slightly-engineered/micro-crawler-2x-6mm-planetary-gear-motors/stl/micro crawler body.stl

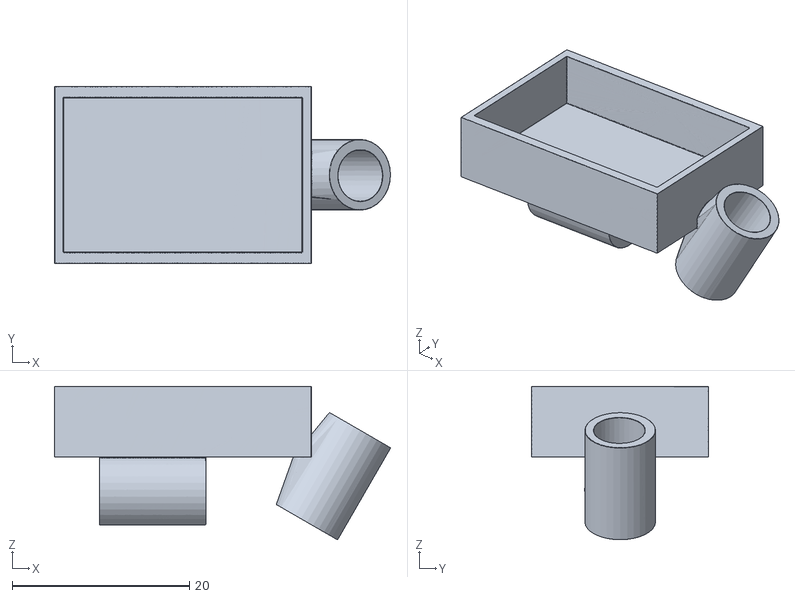
[picture p5: CAD file, 2026-10-30]
stl/micro crawler body.stl
37.9 x 20.0 x 17.3
