slightly-engineered/micro-crawler-2x-6mm-planetary-gear-motors/stl/front motor.stl

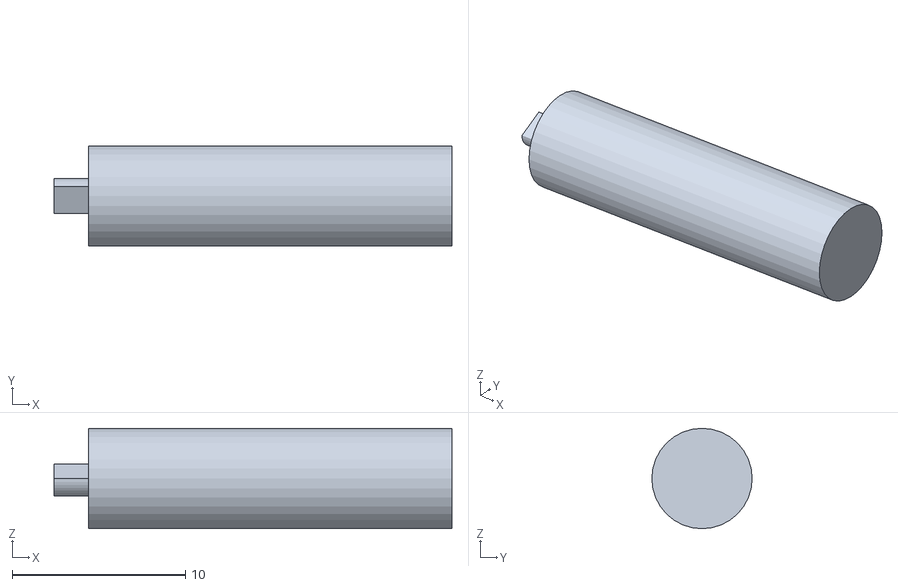
[picture p6: CAD file, 2026-10-30]
stl/front motor.stl
23.0 x 5.80 x 5.80
