slightly-engineered/micro-crawler-2x-6mm-planetary-gear-motors/stl/6mm planetary motor horn.stl

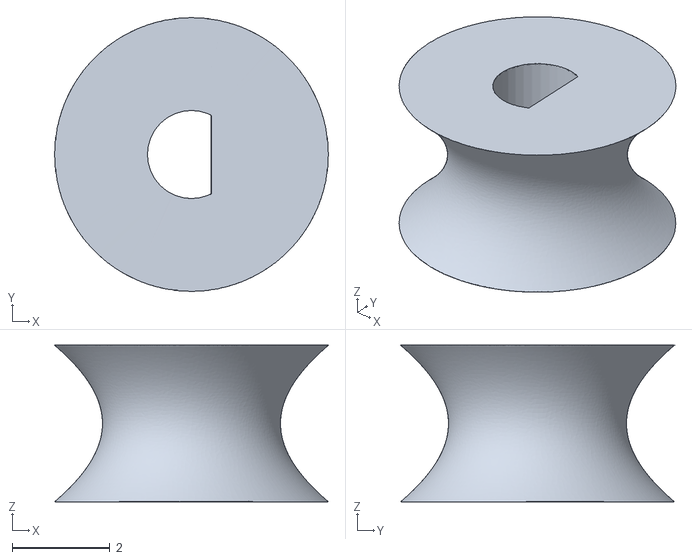
[picture p7: CAD file, 2026-10-30]
stl/6mm planetary motor horn.stl
5.60 x 5.60 x 3.20
