slightly-engineered/micro-crawler-2x-6mm-planetary-gear-motors/stl/rear motor.stl

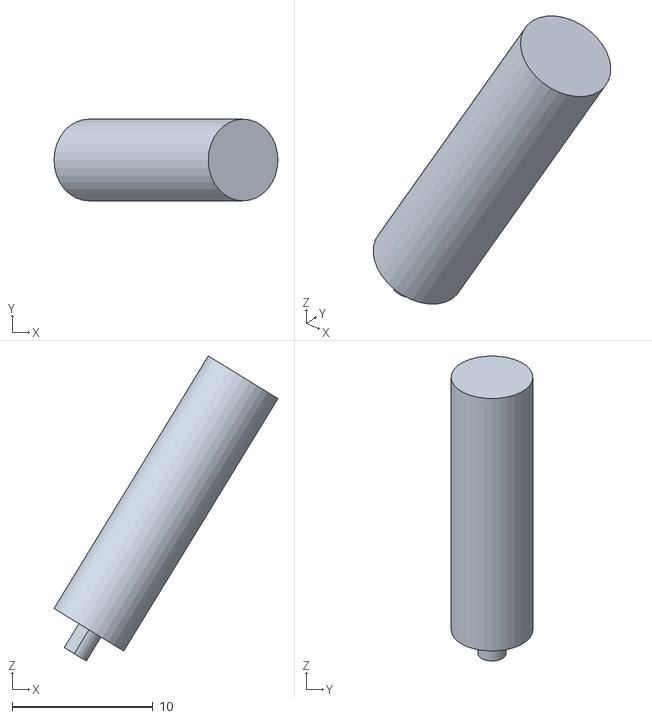
[picture p8: CAD file, 2026-10-30]
stl/rear motor.stl
15.9 x 5.80 x 21.7
