slightly-engineered/micro-crawler-2x-6mm-planetary-gear-motors/stl/DRV8833.stl

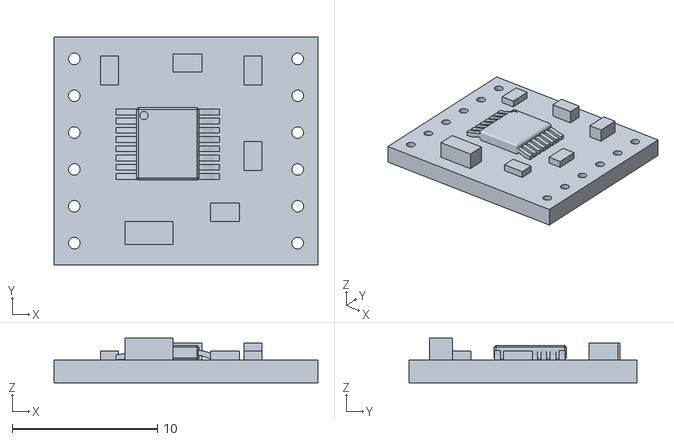
[picture p9: CAD file, 2026-10-30]
stl/DRV8833.stl
18.2 x 15.7 x 3.10
