slightly-engineered/micro-crawler-2x-6mm-planetary-gear-motors/stl/battery dummy.stl

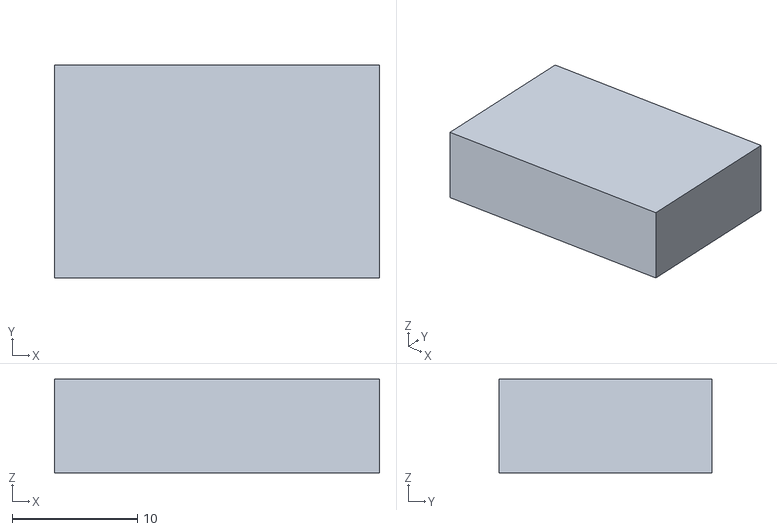
[picture p10: CAD file, 2026-10-30]
stl/battery dummy.stl
26.0 x 17.0 x 7.50
