slightly-engineered/micro-crawler-2x-6mm-planetary-gear-motors/stl/Arduino ESP32-C3.stl

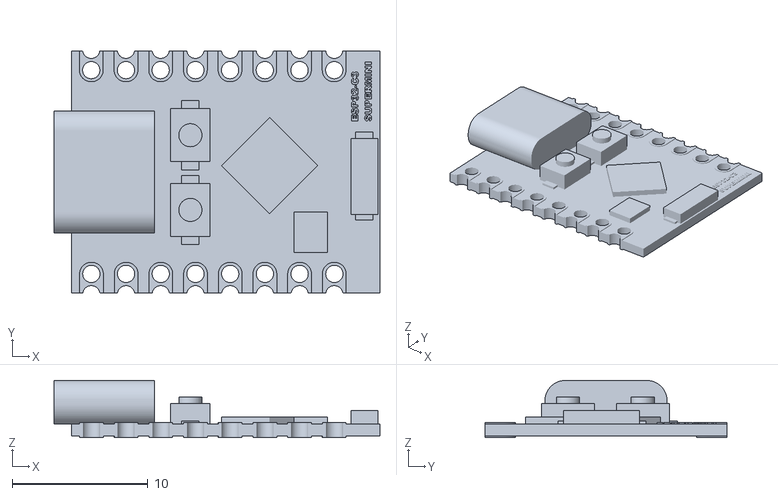
[picture p11: CAD file, 2026-10-30]
stl/Arduino ESP32-C3.stl
24.0 x 17.8 x 4.20
