slightly-engineered/micro-crawler-2x-6mm-planetary-gear-motors/stl/6mm planetary motor horn v2.stl

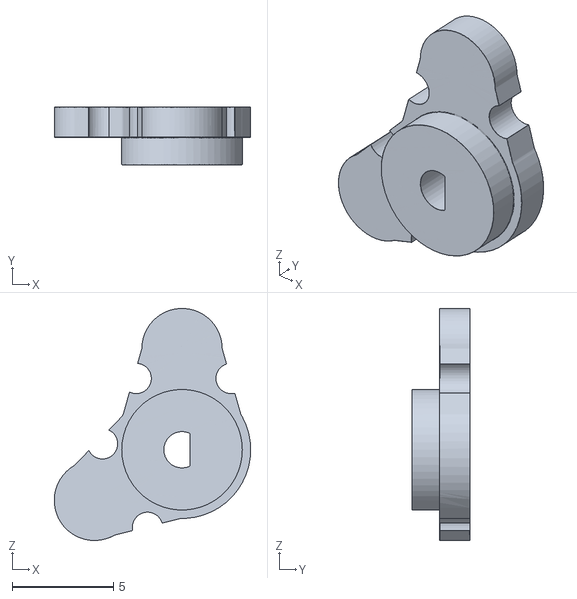
[picture p12: CAD file, 2026-10-30]
stl/6mm planetary motor horn v2.stl
9.71 x 2.87 x 11.5
