slightly-engineered/micro-crawler-2x-6mm-planetary-gear-motors/(commit log)

2026-10-30 Add decimated STL files, setup script, and parts list
    [6mm planetary motor horn v2.stl, 6mm planetary motor horn.stl, Arduino ESP32-C3.stl, DRV8833.stl, battery dummy.stl, front motor.stl, micro crawler body.stl, rear motor.stl]
2026-10-30 Rename board to ESP32-C3 Super Mini
